Diodes-Delight/tin-snipe-afe/README.md

# Tin Snipe Analog Frontend

Tin Snipe is a multimeter for the hardware engineer on the go.

More to follow.
