Diodes-Delight/tin-snipe-afe/mcxa-test-shield/mcxa-test-shield.pdf

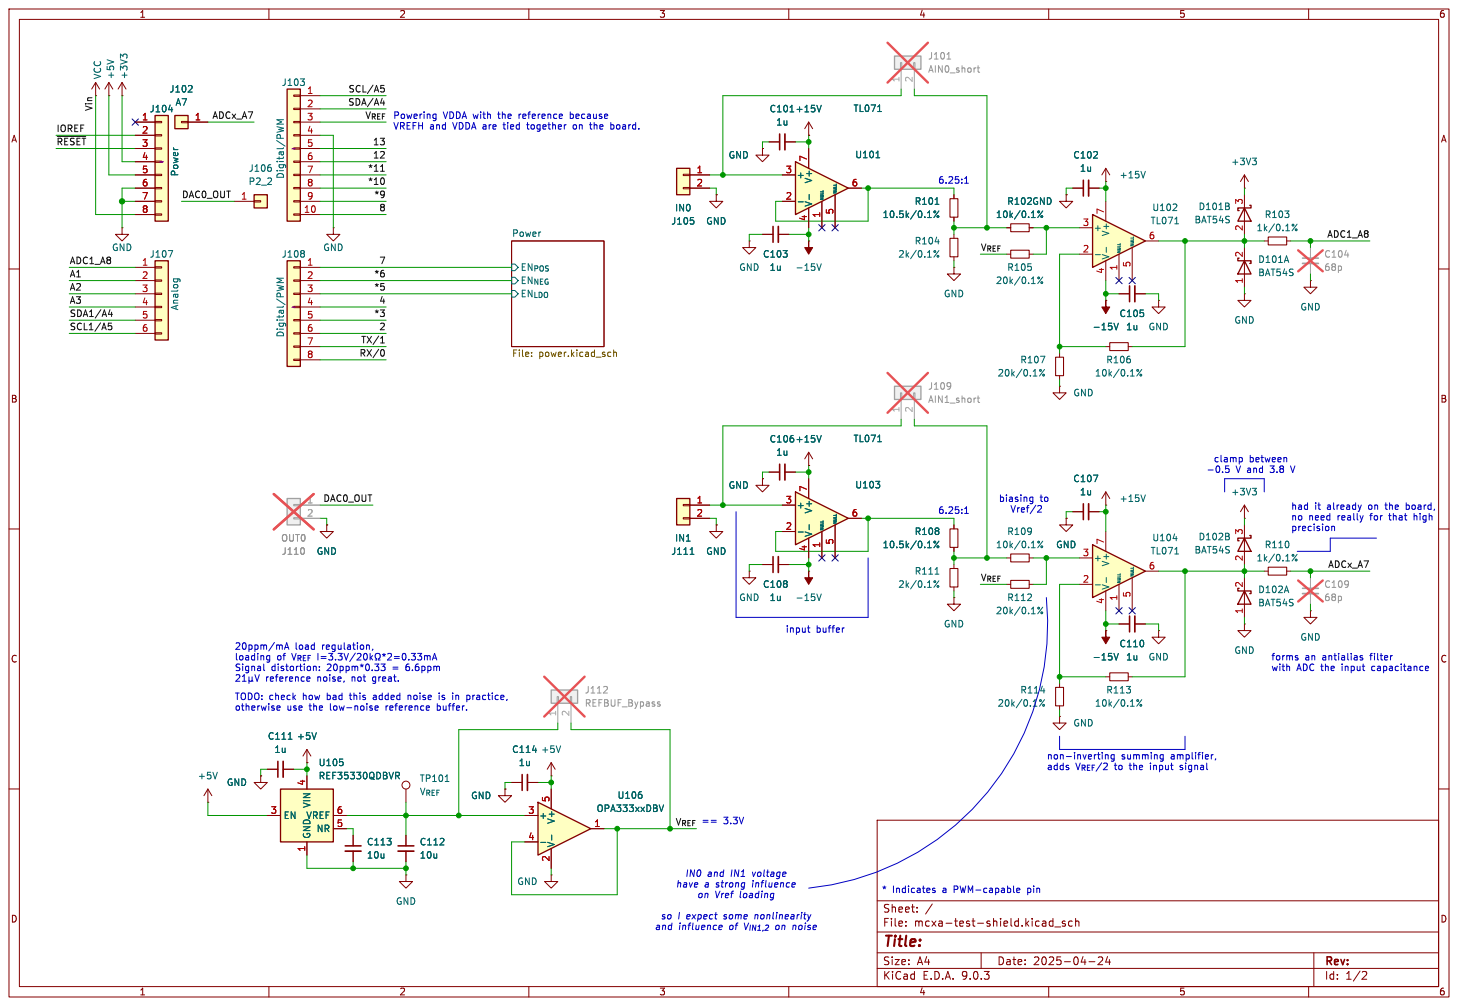
[picture p1: page 1]

had it already on the board, no need really for that high

1 VREF 6 NR 5 GND GND

Id: 1/2 Title: File: mcxa-test-shield.kicad_sch Sheet: /

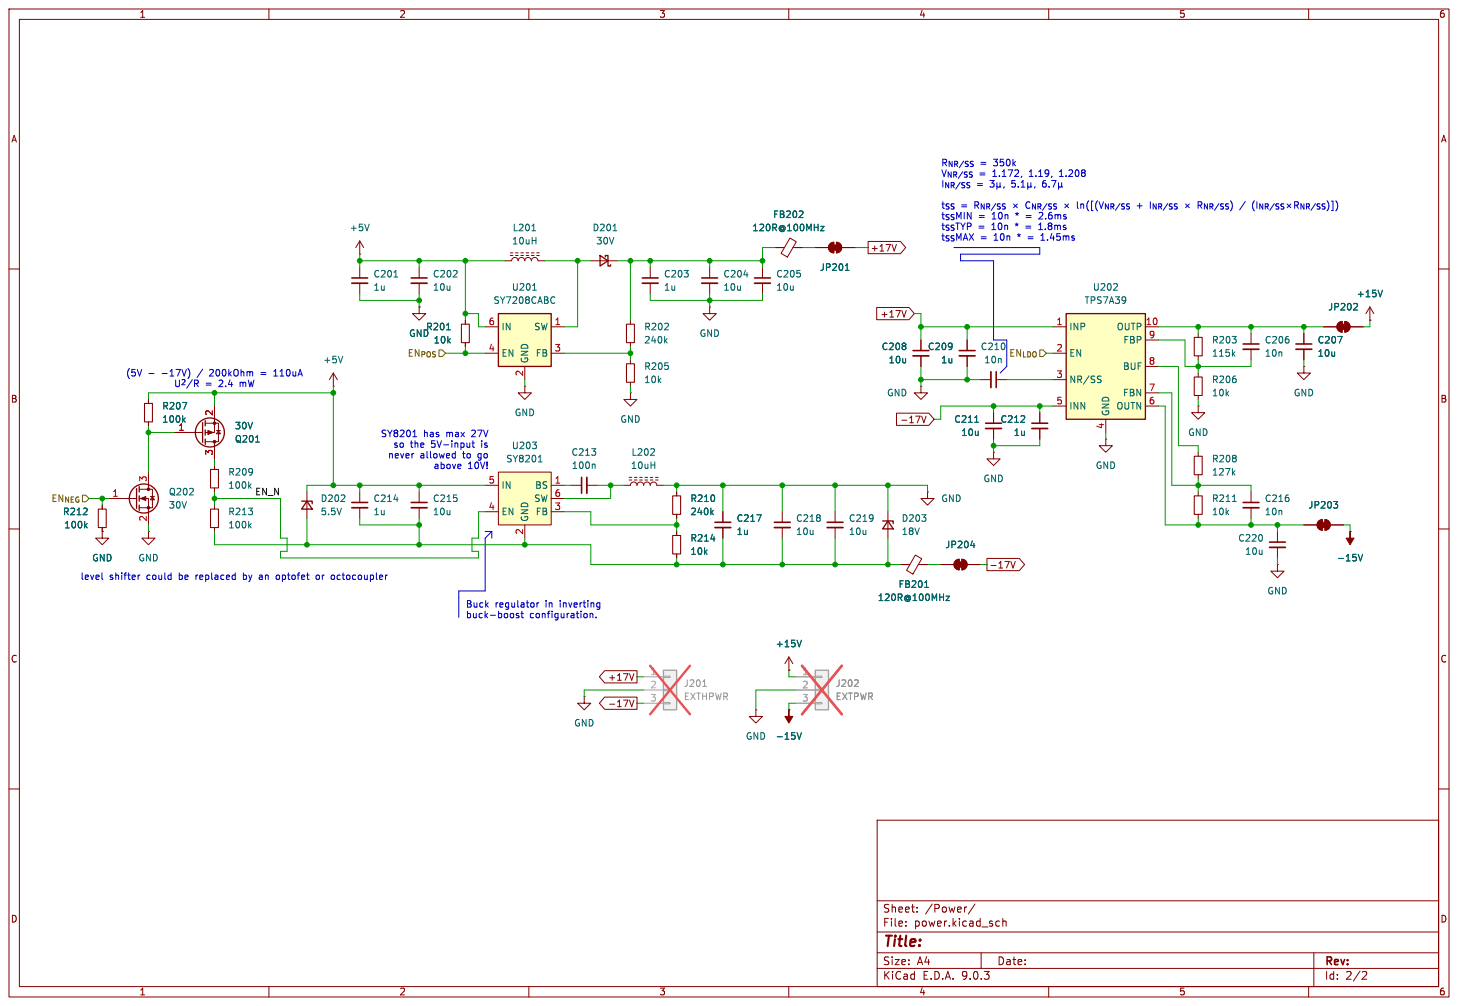
[picture p2: page 2]

120R@100MHz 1

t_{SS}MIN= 10n * = 2.6ms
t_{SS}TYP= 10n * = 1.8ms
t_{SS}MAX= 10n * = 1.45ms

4 OUTP 10 FBP 9 BUF 8 FBN 7 OUTN 6 U202 TPS7A39
