Diodes-Delight/tin-snipe-afe/attenuator-amplifier/attenuator-amplifier.kicad_pcb

## KiCad design attenuator-amplifier/attenuator-amplifier.kicad_pcb (2025-07-23)

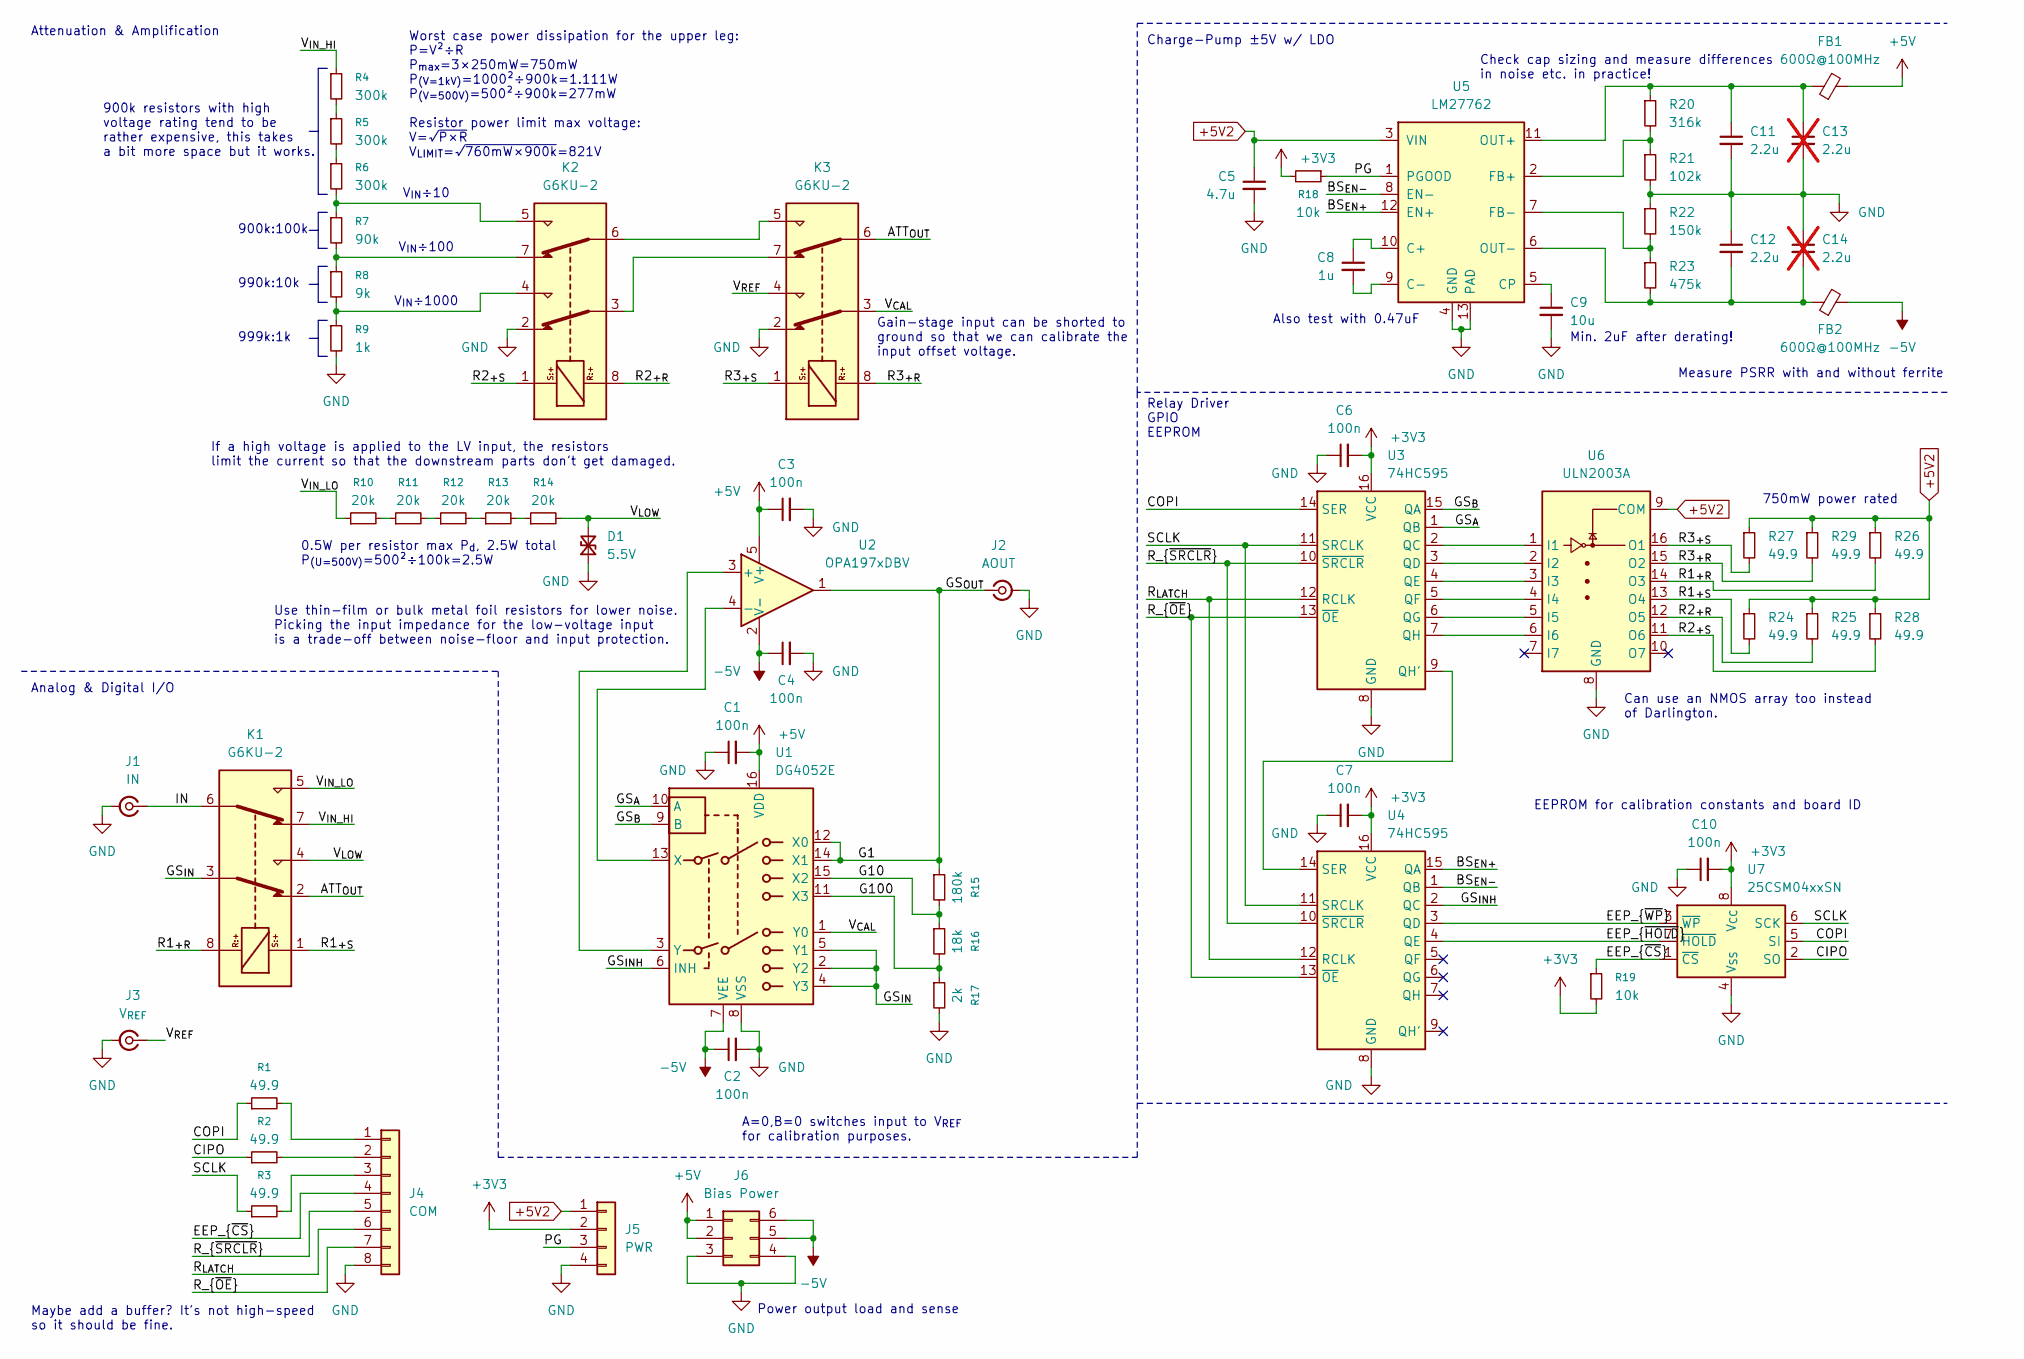
[picture p3: schematic attenuator-amplifier.kicad_sch]

Parts:
C1, C2, C3, C4, C6, C7, C10: 100n; C_0402_1005Metric; MPN FN15X104K500PKG
C5: 4.7u; C_0603_1608Metric; MPN TCC0603X7R475K100CT
C8: 1u; C_0603_1608Metric; MPN CGA0603X7R105K250JT
C9: 10u; C_0603_1608Metric; MPN GRM188Z71A106MA73D
C11, C12: 2.2u; C_0603_1608Metric; MPN GRM188Z71E225KE43D
C13, C14: 2.2u; C_0603_1608Metric; MPN GRM188Z71E225KE43D; not fitted
D1: 5.5V; D_SOD-882D; MPN PESD5V0H1BLG-QZ
FB1, FB2: 600Ω@100MHz; L_0603_1608Metric; MPN 74404024220
J1: IN; SMB_Jack_Vertical; MPN 61611002121501
J2: AOUT; SMB_Jack_Vertical; MPN 61611002121501
J3: V_{REF}; SMB_Jack_Vertical; MPN 61611002121501
J4: COM; PinSocket_1x08_P2.54mm_Vertical
J5: PWR; PinSocket_1x04_P2.54mm_Vertical
J6: Bias Power; PinHeader_2x03_P2.54mm_Vertical
K1, K2, K3: G6KU-2; Relay_DPDT_Omron_G6K-2F-Y; MPN G6KU-2F-Y-TR DC5; LCSC C2153173
R1, R2, R3: 49.9; R_0603_1608Metric; MPN 0603WAF499JT5E
R4, R5, R6: 300k; R_1206_3216Metric; MPN RT1206BRD07300KL
R7: 90k; R_1206_3216Metric; MPN RT1206BRE0790KL
R8: 9k; R_1206_3216Metric; MPN RT1206BRD079KL
R9: 1k; R_1206_3216Metric; MPN RT1206BRD071KL
R10, R11, R12, R13, R14: 20k; R_1206_3216Metric; MPN RNCP1206FTD20K0
R15: 180k; R_0603_1608Metric; MPN RT0603BRB07180KL
R16: 18k; R_0603_1608Metric; MPN RT0603BRB0718KL
R17: 2k; R_0603_1608Metric; MPN AR03BTBX2001
R18, R19: 10k; R_0603_1608Metric; MPN ARG03DTC1002
R20: 316k; R_0402_1005Metric; MPN FRC0402F3163TS
R21: 102k; R_0402_1005Metric; MPN 0402WGF1023TCE
R22: 150k; R_0402_1005Metric; MPN AECR0402F150KK9
R23: 475k; R_0402_1005Metric; MPN HPCR0402F475KK9
R24, R25, R26, R27, R28, R29: 49.9; R_1210_3225Metric; MPN HP0707F499JT5E; LCSC C2759009
U1: DG4052E; SOIC-16_3.9x9.9mm_P1.27mm; MPN DG4052EEY-T1-GE3
U2: OPA197xDBV; SOT-23-5; MPN OPA197IDBVT
U3, U4: 74HC595; SOIC-16_3.9x9.9mm_P1.27mm; MPN SN74HCS595
U5: LM27762; WSON-12-1EP_3x2mm_P0.5mm_EP1x2.65_ThermalVias; MPN LM27762DSSR
U6: ULN2003A; SOIC-16_3.9x9.9mm_P1.27mm; MPN ULN2003ADR
U7: 25CSM04xxSN; SOIC-8_3.9x4.9mm_P1.27mm; MPN FT25C32A-USR-T

Connections:
+3V3: C6.2, C7.2, C10.2, J5.2, R18.2, R19.2, U3.16 (VCC), U4.16 (VCC), U7.8 (V_{CC})
+5V: C1.2, C3.1, FB1.2, J6.1, J6.2, U1.16 (VDD), U2.5 (V+)
+5V2: C5.1, J5.1, R24.1, R25.1, R26.1, R27.1, R28.1, R29.1, U5.3 (VIN), U6.9 (COM)
-5V: C2.1, C4.1, FB2.2, J6.5, J6.6, U1.7 (VEE), U2.2 (V-)
/ATT_{OUT}: K1.2, K3.6
/BS_{EN+}: U4.15 (QA), U5.12 (EN+)
/BS_{EN-}: U4.1 (QB), U5.8 (EN-)
/CIPO: R2.1, U7.2 (SO)
/COPI: R1.1, U3.14 (SER), U7.5 (SI)
/EEP_{~CS}: J4.4, R19.1, U7.1 (~CS)
/EEP_{~HOLD}: U4.4 (QE), U7.7 (~HOLD)
/EEP_{~WP}: U4.3 (QD), U7.3 (~WP)
/G1: J2.1 (In), R15.1, U1.12 (X0), U1.14 (X1), U2.1
/G10: R15.2, R16.1, U1.15 (X2)
/G100: R16.2, R17.1, U1.11 (X3)
/GS_{A}: U1.10 (A), U3.1 (QB)
/GS_{B}: U1.9 (B), U3.15 (QA)
/GS_{INH}: U1.6 (INH), U4.2 (QC)
/GS_{IN}: K1.3, U1.2 (Y2), U1.4 (Y3), U1.5 (Y1)
/IN: J1.1 (In), K1.6
/PG: J5.3, R18.1, U5.1 (PGOOD)
/R1_{+R}: K1.8, R26.2, U6.14 (O3)
/R1_{+S}: K1.1, R24.2, U6.13 (O4)
/R2_{+R}: K2.8, R25.2, U6.12 (O5)
/R2_{+S}: K2.1, R28.2, U6.11 (O6)
/R3_{+R}: K3.8, R29.2, U6.15 (O2)
/R3_{+S}: K3.1, R27.2, U6.16 (O1)
/R_{LATCH}: J4.6, U3.12 (RCLK), U4.12 (RCLK)
/R_{~OE}: J4.7, U3.13 (~OE), U4.13 (~OE)
/R_{~SRCLR}: J4.5, U3.10 (~SRCLR), U4.10 (~SRCLR)
/SCLK: R3.1, U3.11 (SRCLK), U4.11 (SRCLK), U7.6 (SCK)
/V_{CAL}: K3.3, U1.1 (Y0)
/V_{IN_HI}: K1.7, R4.1
/V_{IN_LO}: K1.5, R10.1
/V_{LOW}: D1.2 (A2), K1.4, R14.2
/V_{REF}: J3.1 (In), K3.4
GND: C1.1, C2.2, C3.2, C4.2, C5.2, C6.1, C7.1, C9.2, C10.1, C11.2, C12.1, C13.2, C14.1, D1.1 (A1), J1.2 (Ext), J2.2 (Ext), J3.2 (Ext), J4.8, J5.4, J6.3, J6.4, K2.2, K3.2, R9.2, R17.2, R21.2, R22.1, U1.8 (VSS), U3.8 (GND), U4.8 (GND), U5.4 (GND), U5.13 (PAD), U6.8 (GND), U7.4 (V_{SS})
unnamed: J4.1, R1.2
unnamed: J4.2, R2.2
unnamed: J4.3, R3.2
unnamed: K2.3, K3.7
unnamed: K2.4, R8.2, R9.1
unnamed: K2.5, R6.2, R7.1
unnamed: K2.6, K3.5
unnamed: K2.7, R7.2, R8.1
unnamed: R4.2, R5.1
unnamed: R5.2, R6.1
unnamed: R10.2, R11.1
unnamed: R11.2, R12.1
unnamed: R12.2, R13.1
unnamed: R13.2, R14.1
unnamed: U1.13 (X), U2.4 (-)
unnamed: U1.3 (Y), U2.3 (+)
unnamed: U3.2 (QC), U6.1 (I1)
unnamed: U3.3 (QD), U6.2 (I2)
unnamed: U3.4 (QE), U6.3 (I3)
unnamed: U3.5 (QF), U6.4 (I4)
unnamed: U3.6 (QG), U6.5 (I5)
unnamed: U3.9 (QH'), U4.14 (SER)
unnamed: U3.7 (QH), U6.6 (I6)
unnamed: C8.1, U5.10 (C+)
unnamed: C8.2, U5.9 (C-)
unnamed: C9.1, U5.5 (CP)
unnamed: R20.2, R21.1, U5.2 (FB+)
unnamed: R22.2, R23.1, U5.7 (FB-)
unnamed: C11.1, C13.1, FB1.1, R20.1, U5.11 (OUT+)
unnamed: C12.2, C14.2, FB2.1, R23.2, U5.6 (OUT-)

Notes on the sheet:
Gain-stage input can be shorted to ground so that we can calibrate the input offset voltage.
Relay Driver GPIO EEPROM
Attenuation & Amplification
If a high voltage is applied to the LV input, the resistors limit the current so that the downstream parts don't get damaged.
Check cap sizing and measure differences in noise etc. in practice!
EEPROM for calibration constants and board ID
Power output load and sense
999k:1k
A=0,B=0 switches input to V_{REF} for calibration purposes.
V_{IN}÷100
Maybe add a buffer? It's not high-speed so it should be fine.
0.5W per resistor max P_{d}, 2.5W total P_{(U=500V)}=500²÷100k=2.5W
900k resistors with high voltage rating tend to be rather expensive, this takes a bit more space but it works.
Measure PSRR with and without ferrite
Charge-Pump ±5V w/ LDO
V_{IN}÷10
750mW power rated
Also test with 0.47uF
V_{IN}÷1000
Worst case power dissipation for the upper leg: P=V²÷R P_{max}=3×250mW=750mW P_{(V=1kV)}=1000²÷900k=1.111W P_{(V=500V)}=500²÷900k=277mW Resistor power limit max voltage: V=√~{P×R} V_{LIMIT}=√~{760mW×900k}=821V
Use thin-film or bulk metal foil resistors for lower noise. Picking the input impedance for the low-voltage input is a trade-off between noise-floor and input protection.
900k:100k
Analog & Digital I/O
990k:10k
Min. 2uF after derating!
Can use an NMOS array too instead of Darlington.

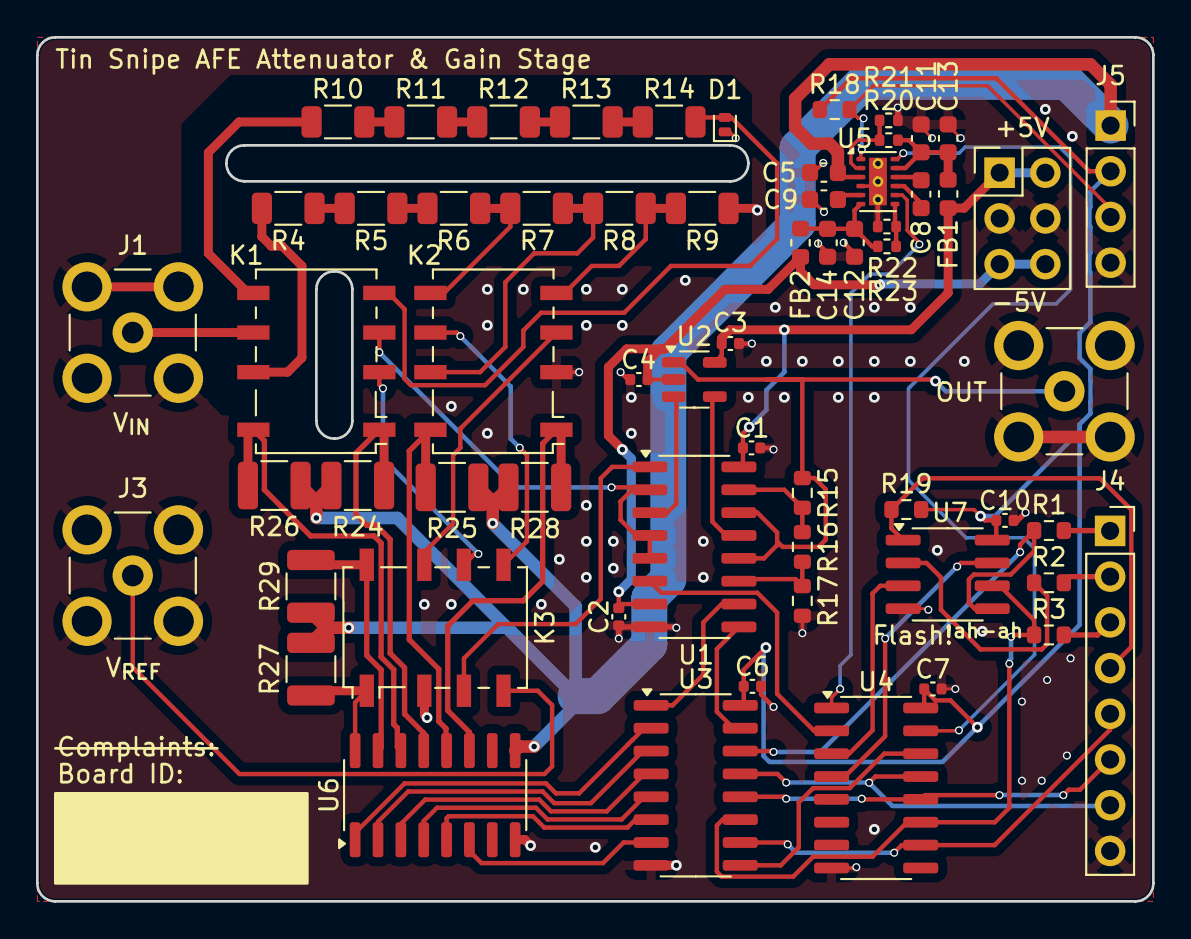
[picture p4: board attenuator-amplifier.kicad_pcb from above]

Board: 4 copper layers, 62.0 x 48.0 mm, 62 parts (0 on the bottom side), 67 nets.
