Diodes-Delight/tin-snipe-afe/mcxa-test-shield/mcxa-test-shield.kicad_pcb

## KiCad design mcxa-test-shield/mcxa-test-shield.kicad_pcb (2025-07-22)

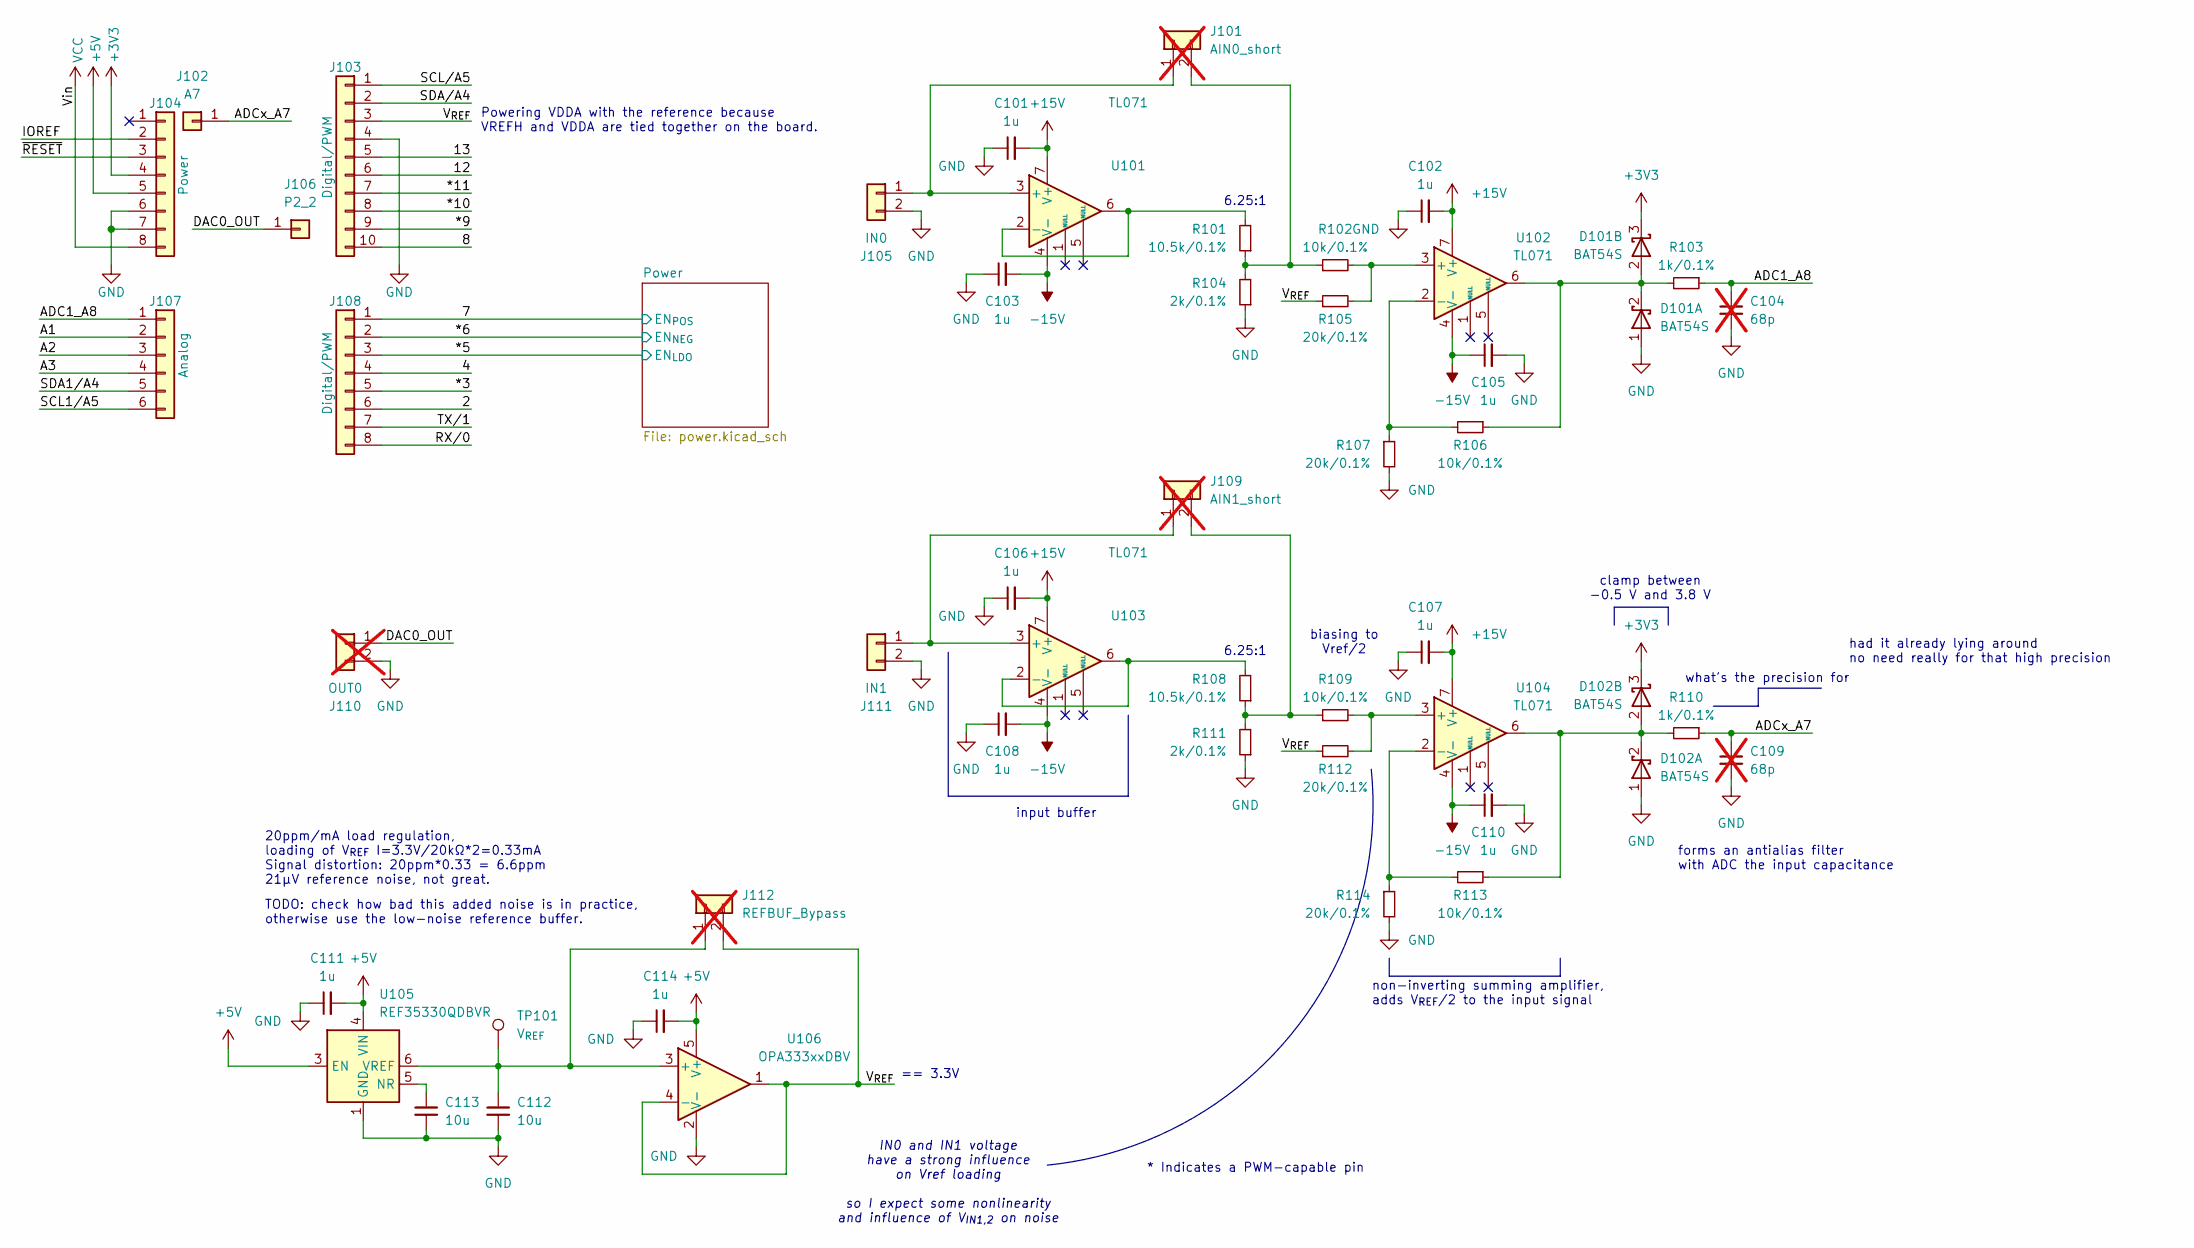
[picture p5: schematic mcxa-test-shield.kicad_sch]

Parts:
C101, C102, C103, C105, C106, C107, C108, C110, C111, C114: 1u; C_0402_1005Metric; MPN CL05A105KA5NQNC; LCSC C52923
C104, C109: 68p; C_0603_1608Metric; not fitted
C112, C113: 10u; C_0402_1005Metric; MPN CL05A106MQ5NUNC; LCSC C15525
D101, D102: BAT54S; SOT-23-3
J101: AIN0_short; PinHeader_1x02_P2.54mm_Vertical; not fitted
J102: A7; PinHeader_1x01_P2.54mm_Vertical
J103: Digital/PWM; PinSocket_1x10_P2.54mm_Vertical
J104: Power; PinSocket_1x08_P2.54mm_Vertical
J105: IN0; PinHeader_1x02_P2.54mm_Vertical
J106: P2_2; PinHeader_1x01_P2.54mm_Vertical
J107: Analog; PinSocket_1x06_P2.54mm_Vertical
J108: Digital/PWM; PinSocket_1x08_P2.54mm_Vertical
J109: AIN1_short; PinHeader_1x02_P2.54mm_Vertical; not fitted
J110: OUT0; PinHeader_1x02_P2.54mm_Vertical; not fitted
J111: IN1; PinHeader_1x02_P2.54mm_Vertical
J112: REFBUF_Bypass; PinHeader_1x02_P2.54mm_Vertical; not fitted
R101, R108: 10.5k/0.1%; R_0603_1608Metric; MPN PTFR0603B10K5N9; LCSC C2692889
R102, R106, R109, R113: 10k/0.1%; R_0603_1608Metric; MPN RT0603BRD0710KL; LCSC C95204
R103, R110: 1k/0.1%; R_0603_1608Metric; MPN AR03BTB1001; LCSC C408913
R104, R111: 2k/0.1%; R_0603_1608Metric; MPN PTFR0603B2K00N9; LCSC C394539
R105, R107, R112, R114: 20k/0.1%; R_0603_1608Metric; MPN RT0603BRD0720KL; LCSC C723637
TP101: V_{REF}; TestPoint_Pad_D1.5mm
U101, U102, U103, U104: TL071; SOIC-8_3.9x4.9mm_P1.27mm
U105: REF35330QDBVR; SOT-23-6
U106: OPA333xxDBV; SOT-23-5

Connections:
+3V3: D101.3 (K), D102.3 (K), J104.4
+5V: C111.2, C114.2, J104.5, U105.3 (EN), U105.4 (VIN), U106.5 (V+); also elsewhere on the board
+15V: C101.2, C102.2, C106.2, C107.2, U101.7 (V+), U102.7 (V+), U103.7 (V+), U104.7 (V+); also elsewhere on the board
-15V: C103.2, C105.1, C108.2, C110.1, U101.4 (V-), U102.4 (V-), U103.4 (V-), U104.4 (V-); also elsewhere on the board
/2: J108.6
/4: J108.4
/7: J108.1; also elsewhere on the board
/8: J103.10
/12: J103.6
/13: J103.5
/*3: J108.5
/*5: J108.3; also elsewhere on the board
/*6: J108.2; also elsewhere on the board
/*9: J103.9
/*10: J103.8
/*11: J103.7
/A1: J107.2
/A2: J107.3
/A3: J107.4
/ADC1_A8: C104.1, J107.1, R103.1
/ADCx_A7: C109.1, J102.1, R110.1
/DAC0_OUT: J106.1, J110.1
/IOREF: J104.2
/RX/0: J108.8
/SCL1/A5: J107.6
/SCL/A5: J103.1
/SDA1/A4: J107.5
/SDA/A4: J103.2
/TX/1: J108.7
/V_{REF}: J103.3, J112.2, R105.1, R112.1, U106.1, U106.4 (-)
/~RESET: J104.3
GND: C101.1, C102.1, C103.1, C104.2, C105.2, C106.1, C107.1, C108.1, C109.2, C110.2, C111.1, C112.2, C113.2, C114.1, D101.1 (A), D102.1 (A), J103.4, J104.6, J104.7, J105.2, J110.2, J111.2, R104.1, R107.2, R111.1, R114.2, U105.1 (GND), U105.2 (GND), U106.2 (V-); also elsewhere on the board
unnamed: D101.2 (K), R103.2, R106.1, U102.6
unnamed: D102.2 (K), R110.2, R113.1, U104.6
unnamed: J101.1, J105.1, U101.3 (+)
unnamed: J101.2, R101.1, R102.1, R104.2
unnamed: J109.1, J111.1, U103.3 (+)
unnamed: J109.2, R108.1, R109.1, R111.2
unnamed: C112.1, J112.1, TP101.1, U105.6 (VREF), U106.3 (+)
unnamed: R101.2, U101.2 (-), U101.6
unnamed: R102.2, R105.2, U102.3 (+)
unnamed: R106.2, R107.1, U102.2 (-)
unnamed: R108.2, U103.2 (-), U103.6
unnamed: R109.2, R112.2, U104.3 (+)
unnamed: R113.2, R114.1, U104.2 (-)
unnamed: C113.1, U105.5 (NR)
VCC: J104.8

Notes on the sheet:
TODO: check how bad this added noise is in practice, otherwise use the low-noise reference buffer.
== 3.3V
6.25:1
what's the precision for
forms an antialias filter with ADC the input capacitance
IN0 and IN1 voltage have a strong influence on Vref loading so I expect some nonlinearity and influence of V_{IN1,2} on noise
non-inverting summing amplifier, adds V_{REF}/2 to the input signal
20ppm/mA load regulation, loading of V_{REF} I=3.3V/20kΩ*2=0.33mA Signal distortion: 20ppm*0.33 = 6.6ppm 21µV reference noise, not great.
input buffer
* Indicates a PWM-capable pin
biasing to Vref/2
clamp between -0.5 V and 3.8 V
had it already lying around no need really for that high precision
Powering VDDA with the reference because VREFH and VDDA are tied together on the board.

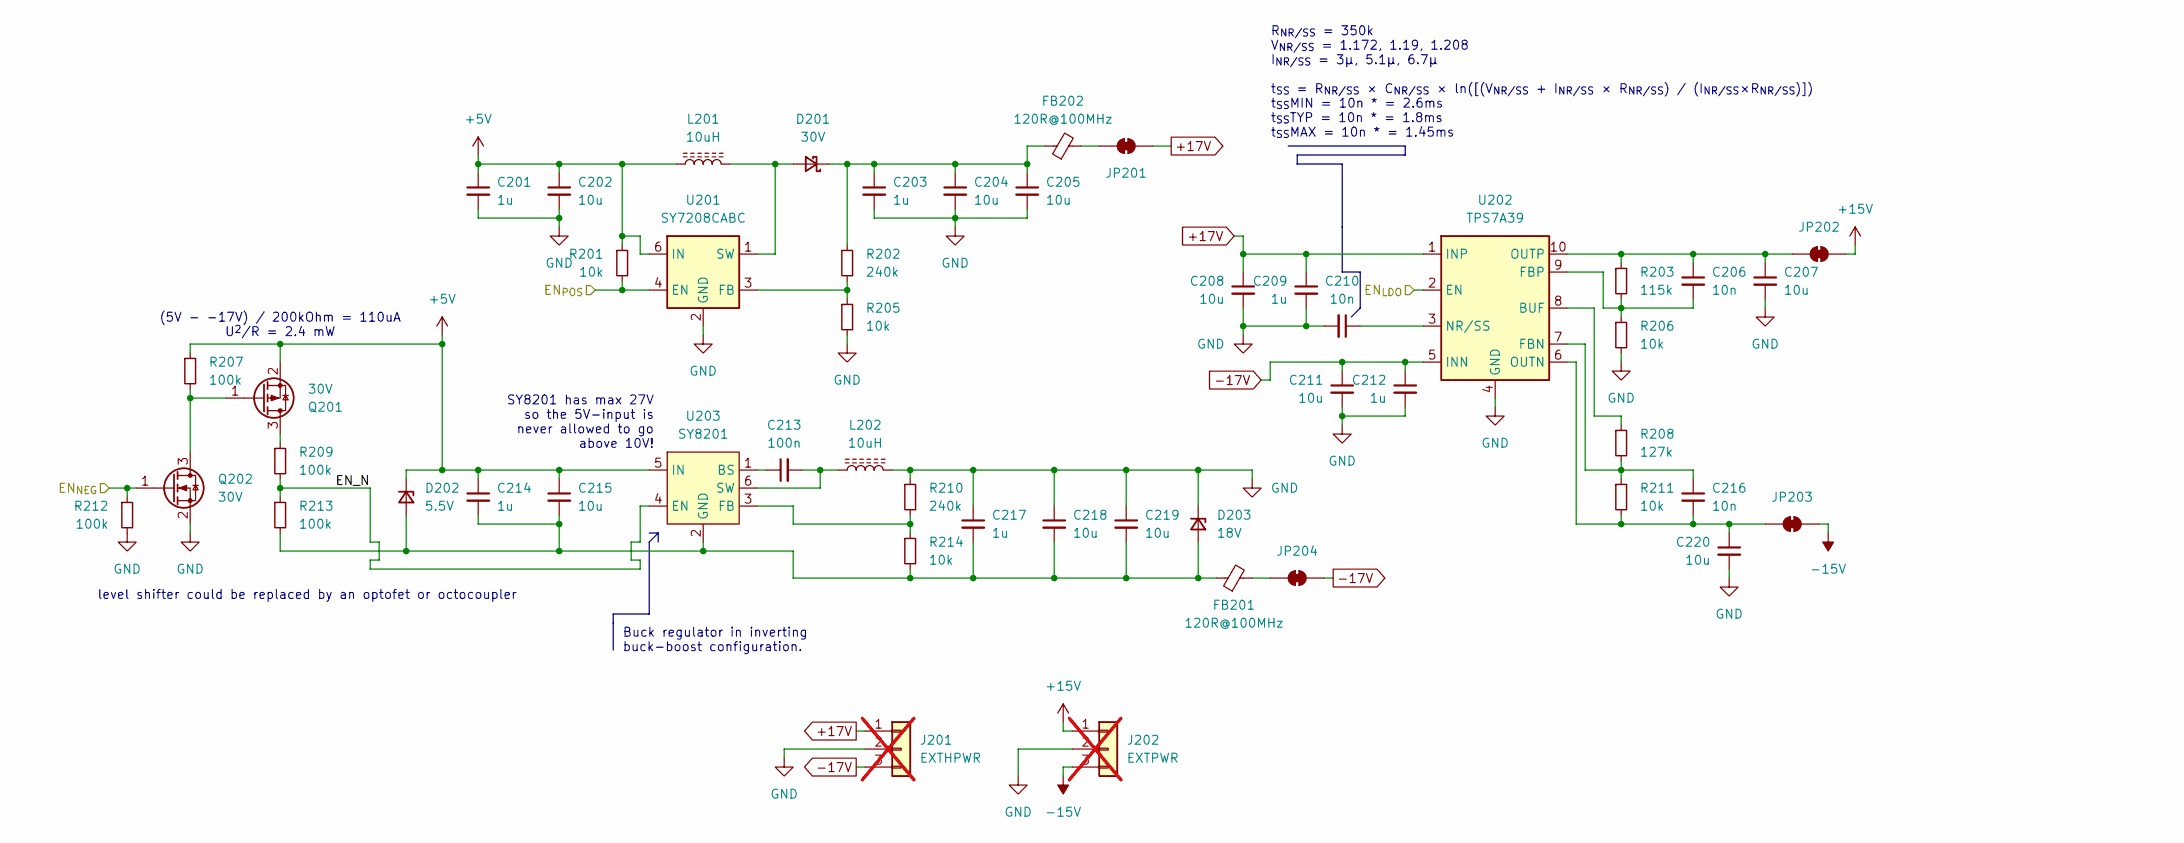
[picture p6: schematic power.kicad_sch]

Parts:
C201, C203, C209, C212, C214, C217: 1u; C_0402_1005Metric; MPN CL05A105KA5NQNC; LCSC C52923
C202, C204, C205, C207, C208, C211, C215, C218, C219, C220: 10u; C_0805_2012Metric; MPN GRM21BR61H106KE43L; LCSC C440198
C206, C210, C216: 10n; C_0402_1005Metric; MPN CL05B103KB5NNNC; LCSC C15195
C213: 100n; C_0402_1005Metric; MPN CL05B104KB54PNC; LCSC C307331
D201: 30V; D_SOD-123FL; MPN RB060MM-30; LCSC C308720
D202: 5.5V; D_SOD-123; MPN BZT52B5V6; LCSC C22399881
D203: 18V; D_SOD-123; MPN MM1Z18B; LCSC C22379455
FB201, FB202: 120R@100MHz; L_0603_1608Metric; MPN BLM18PG121SN1D; LCSC C14709
J201: EXTHPWR; PinHeader_1x03_P2.54mm_Vertical; not fitted
J202: EXTPWR; PinHeader_1x03_P2.54mm_Vertical; not fitted
JP201, JP202, JP204: PWR_{POS}; SolderJumper-2_P1.3mm_Bridged_RoundedPad1.0x1.5mm
JP203: PWR_{NEG}; SolderJumper-2_P1.3mm_Bridged_RoundedPad1.0x1.5mm
L201, L202: 10uH; L_Changjiang_FNR4030S; MPN FNR4030S100MT; LCSC C167879
Q201: 30V; SOT-23; MPN AO3401A; LCSC C15127
Q202: 30V; SOT-23; MPN AO3400A; LCSC C20917
R201, R205, R206, R211, R214: 10k; R_0603_1608Metric; MPN 0603WAF1002T5E; LCSC C25804
R202, R210: 240k; R_0603_1608Metric; MPN 0603WAF2403T5E; LCSC C4197
R203: 115k; R_0603_1608Metric; MPN 0603WAF1003T5E; LCSC C25803
R207, R209, R212, R213: 100k; R_0402_1005Metric; MPN 0402WGF1003TCE; LCSC C25741
R208: 127k; R_0603_1608Metric; MPN ARG03FTC1273; LCSC C217715
U201: SY7208CABC; SOT-23-6; JLC SOT-23-6
U202: TPS7A39; Texas_S-PVSON-N10_ThermalVias; MPN TPS7A3901DSCR; LCSC C2685819
U203: SY8201; SOT-23-6; MPN SY8201ABC; LCSC C108052

Connections:
+5V: C201.1, C202.1, C214.1, C215.1, D202.1 (K), L201.1, Q201.2 (S), R201.1, R207.1, U201.5 (NC), U201.6 (IN), U203.5 (IN); also elsewhere on the board
+15V: J202.1, JP202.2 (B); also elsewhere on the board
+17V: C208.1, C209.1, J201.1, JP201.2 (B), U202.1 (INP)
-15V: J202.3, JP203.2 (B); also elsewhere on the board
-17V: C211.1, C212.1, J201.3, JP204.2 (B), U202.5 (INN)
/7: R201.2, U201.4 (EN); also elsewhere on the board
/*5: U202.2 (EN); also elsewhere on the board
/*6: Q202.1 (G), R212.1; also elsewhere on the board
/Power/EN_N: R209.2, R213.1, U203.4 (EN)
GND: C201.2, C202.2, C203.2, C204.2, C205.2, C207.2, C208.2, C209.2, C210.2, C211.2, C212.2, C217.1, C218.1, C219.1, C220.2, D203.1 (K), J201.2, J202.2, L202.2, Q202.2 (S), R205.2, R206.2, R210.1, R212.2, U201.2 (GND), U202.4 (GND), U202.11 (GND); also elsewhere on the board
unnamed: D201.2 (A), L201.2, U201.1 (SW)
unnamed: C203.1, C204.1, C205.1, D201.1 (K), FB202.1, R202.1
unnamed: C214.2, C215.2, C217.2, C218.2, C219.2, D202.2 (A), D203.2 (A), FB201.1, R213.2, R214.2, U203.2 (GND)
unnamed: FB202.2, JP201.1 (A)
unnamed: C206.1, C207.1, JP202.1 (A), R203.1, U202.10 (OUTP)
unnamed: C216.2, C220.1, JP203.1 (A), R211.2, U202.6 (OUTN)
unnamed: FB201.2, JP204.1 (A)
unnamed: Q201.3 (D), R209.1
unnamed: Q201.1 (G), Q202.3 (D), R207.2
unnamed: R202.2, R205.1, U201.3 (FB)
unnamed: R208.1, U202.8 (BUF)
unnamed: C216.1, R208.2, R211.1, U202.7 (FBN)
unnamed: C206.2, R203.2, R206.1, U202.9 (FBP)
unnamed: C210.1, U202.3 (NR/SS)
unnamed: C213.1, U203.1 (BS)
unnamed: R210.2, R214.1, U203.3 (FB)
unnamed: C213.2, L202.1, U203.6 (SW)

Notes on the sheet:
Buck regulator in inverting buck-boost configuration.
R_{NR/SS} = 350k V_{NR/SS} = 1.172, 1.19, 1.208 I_{NR/SS} = 3µ, 5.1µ, 6.7µ t_{SS} = R_{NR/SS} × C_{NR/SS} × ln([(V_{NR/SS} + I_{NR/SS} × R_{NR/SS}) / (I_{NR/SS}×R_{NR/SS})]) t_{SS}MIN = 10n * = 2.6ms t_{SS}TYP = 10n * = 1.8ms t_{SS}MAX = 10n * = 1.45ms
level shifter could be replaced by an optofet or octocoupler
SY8201 has max 27V so the 5V-input is never allowed to go above 10V!
(5V - -17V) / 200kOhm = 110uA U^{2}/R = 2.4 mW

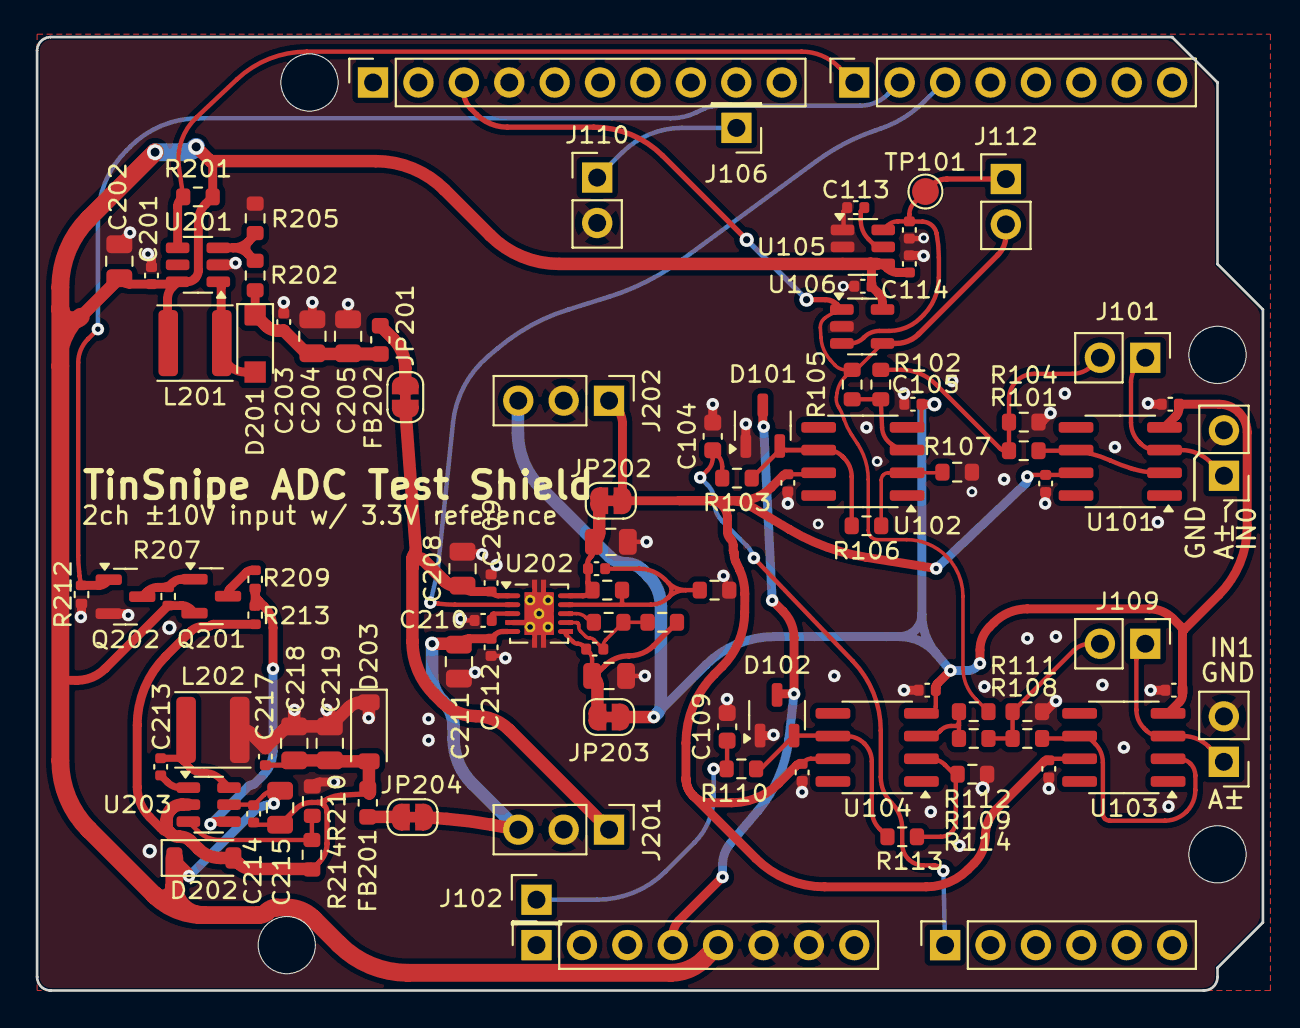
[picture p7: board mcxa-test-shield.kicad_pcb from above]

Board: 4 copper layers, 68.6 x 53.3 mm, 104 parts (0 on the bottom side), 46 nets.

Other parts of the board:
MH1, MH2, MH3, MH4: MountingHole_3.2mm
