Diodes-Delight/tin-snipe-afe/(commit log)

2025-07-22 add input stage and power supplies test shield
    [mcxa-test-shield.kicad_pcb, mcxa-test-shield.kicad_sch, power.kicad_sch]
2025-07-22 attenuator and amplifier draft
    [attenuator-amplifier.kicad_pcb, attenuator-amplifier.kicad_sch]
2025-07-23 small changes, add missing part numbers
    [attenuator-amplifier.kicad_pcb, attenuator-amplifier.kicad_sch, frontend-prot.kicad_sch]
2025-07-24 add pdf schematic for the attenuator shield too
    [mcxa-test-shield.kicad_sch]
2025-08-20 add basic power supply test program
2025-08-27 fix gain and attenuation switching code
    [main.c]
